UjjawalKhatri/rv64im-doom-soc/docs/images/vga_colorbars.png

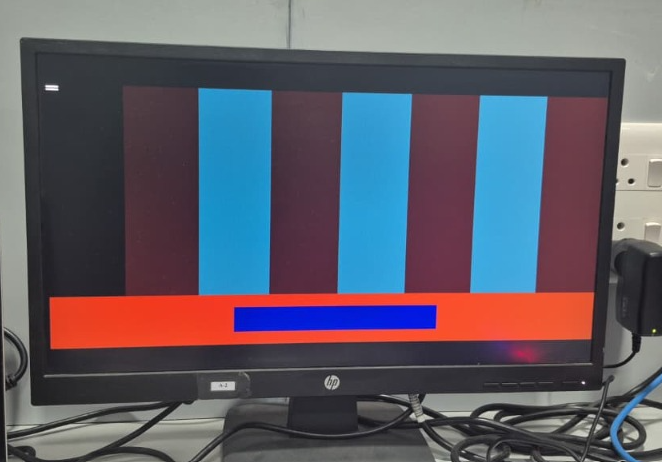
docs/images/vga_colorbars.png
