UjjawalKhatri/rv64im-doom-soc/sim/programs/instructions.txt

00000093
00000113
00000193
00000213
00000293
00000313
00000393
00000413
00000493
00000513
00000593
00000613
00000693
00000713
00000793
00000813
00000893
00000913
00000993
00000a13
00000a93
00000b13
00000b93
00000c13
00000c93
00000d13
00000d93
00000e13
00000e93
00000f13
00000f93
00002117
f7410113
00001297
16c28293
00001317
17030313
0062d863
0002b023
00828293
ff5ff06f
008000ef
0000006f
fe010113
00113c23
00813823
00913423
660000ef
00000593
00000513
78c000ef
00000593
00400513
7a4000ef
00001437
cd040513
225000ef
00001537
d0050513
219000ef
cd040513
211000ef
00400593
00000513
754000ef
00000593
07800513
76c000ef
00001537
d3050513
1ed000ef
00001537
d5050513
1e1000ef
00700593
00000513
724000ef
00000593
07400513
73c000ef
00001537
d8050513
1bd000ef
478000ef
00050493
03200513
4b4000ef
468000ef
00050413
00900593
00000513
6e8000ef
ffff67b7
3c078793
00f407b3
00005737
409787b3
e2070713
08f76e63
07400513
00000593
6e4000ef
00001537
da850513
165000ef
00b00593
00000513
6a8000ef
00000593
00400513
6c0000ef
00001537
de850513
141000ef
0ff00413
000014b7
474000ef
00040793
00050413
fea78ae3
458000ef
00d00593
00000513
668000ef
00000593
07800513
680000ef
3d4000ef
0005061b
0004059b
e0848513
131000ef
434000ef
00040793
00050413
faa78ae3
fc1ff06f
09000513
00000593
64c000ef
00001537
dd050513
0cd000ef
f69ff06f
00060463
0a054e63
08050e63
fc010113
00010613
00100893
00060793
00900313
40c888bb
0080006f
00070513
02b57733
0ff77693
0306881b
0576869b
0ff6f693
00e36463
0ff87693
00d78023
00f8883b
02b55733
00178793
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
786c66e6
00e6666c
606060f0
00fe6662
fefeeec6
00c6c6d6
def6e6c6
00c6c6ce
c6c6c67c
007cc6c6
7c6666fc
00f06060
c6c6c67c
0e7ccec6
7c6666fc
00e6666c
3860c67c
007cc60c
18185a7e
003c1818
c6c6c6c6
007cc6c6
c6c6c6c6
00386cc6
d6c6c6c6
00c6eefe
386cc6c6
00c6c66c
3c666666
003c1818
180cc6fe
00fe6230
3030303c
003c3030
183060c0
0002060c
0c0c0c3c
003c0c0c
c66c3810
00000000
00000000
ff000000
000c1830
00000000
0c780000
0076cc7c
667c60e0
007c6666
c67c0000
007cc6c0
cc7c0c1c
0076cccc
c67c0000
007cc0fe
f0606c38
00f06060
cc760000
f80c7ccc
766c60e0
00e66666
18380018
003c1818
060e0006
3c666606
6c6660e0
00e66c78
18181838
003c1818
feec0000
00d6d6d6
66dc0000
00666666
c67c0000
007cc6c6
66dc0000
f0607c66
cc760000
1e0c7ccc
76dc0000
00f06060
c07c0000
00fc067c
30fc3030
00183430
cccc0000
0076cccc
c6c60000
00386cc6
c6c60000
006cfed6
6cc60000
00c66c38
c6c60000
fc067ec6
4cfe0000
00fe3218
070c0c38
00380c0c
00181818
00181818
380c0c07
00070c0c
00003b6e
00000000
00000000
00000000
00000004
00000013
00000013
00000013
00000013
00000013
00000013
00000013
00000013
00000013
00000013
00000013
00000013
00000013
00000013
00000013
00000013
00000013
00000013
00000013
00000013
00000013
00000013
00000013
00000013
00000013
00000013
00000013
00000013
00000013
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
