UjjawalKhatri/rv64im-doom-soc/sim/programs/fibonacci_instructions.txt

00
A0
00
93
00
00
01
13
00
10
01
93
00
00
02
93
00
22
B0
23
00
31
02
33
00
01
81
13
00
02
01
93
00
82
82
93
FF
F0
80
93
00
00
86
63
FE
00
02
E3
00
00
00
13
00
00
35
03
00
80
35
83
01
00
36
03
01
80
36
83
02
00
37
03
02
80
37
83
03
00
38
03
03
80
38
83
04
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
