UjjawalKhatri/rv64im-doom-soc/docs/images/diagnostic_tests.png

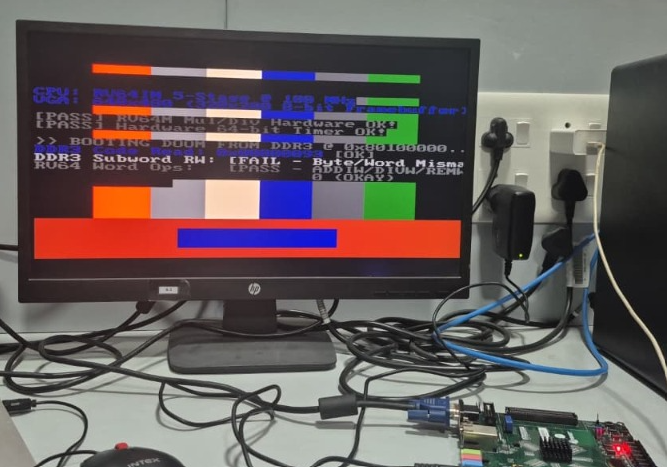
docs/images/diagnostic_tests.png
