UjjawalKhatri/rv64im-doom-soc/docs/images/green_stripes_bug.png

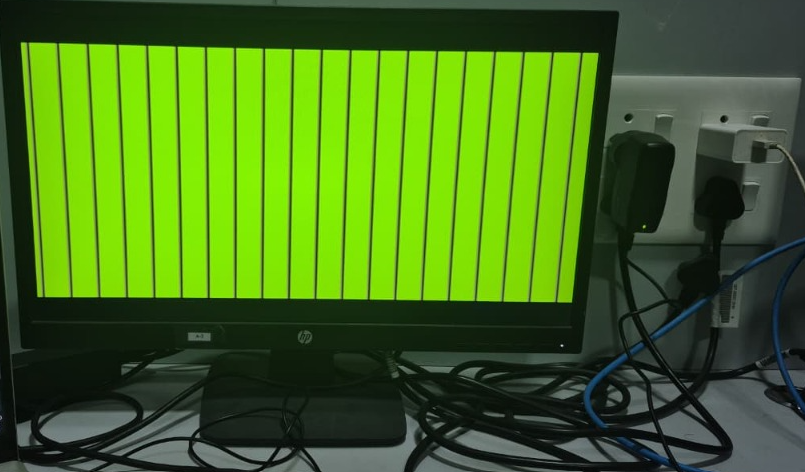
docs/images/green_stripes_bug.png
