UjjawalKhatri/rv64im-doom-soc/sw/doom/doomgeneric/i_system.c

//
// Copyright(C) 1993-1996 Id Software, Inc.
// Copyright(C) 2005-2014 Simon Howard
//
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
// DESCRIPTION:
//



#include <stdlib.h>
#include <stdio.h>
#include <string.h>

#include <stdarg.h>

#ifdef _WIN32
#define WIN32_LEAN_AND_MEAN
#include <windows.h>
#else
#include <unistd.h>
#endif

#ifdef ORIGCODE
#include "SDL.h"
#endif

#include "config.h"

#include "deh_str.h"
#include "doomtype.h"
#include "m_argv.h"
#include "m_config.h"
#include "m_misc.h"
#include "i_joystick.h"
#include "i_sound.h"
#include "i_timer.h"
#include "i_video.h"

#include "i_system.h"

#include "w_wad.h"
#include "z_zone.h"

#ifdef __MACOSX__
#include <CoreFoundation/CFUserNotification.h>
#endif

#define DEFAULT_RAM 6 /* MiB */
#define MIN_RAM     6  /* MiB */


typedef struct atexit_listentry_s atexit_listentry_t;

struct atexit_listentry_s
{
    atexit_func_t func;
    boolean run_on_error;
    atexit_listentry_t *next;
};

static atexit_listentry_t *exit_funcs = NULL;

void I_AtExit(atexit_func_t func, boolean run_on_error)
{
    atexit_listentry_t *entry;

    entry = malloc(sizeof(*entry));

    entry->func = func;
    entry->run_on_error = run_on_error;
    entry->next = exit_funcs;
    exit_funcs = entry;
}

// Tactile feedback function, probably used for the Logitech Cyberman

void I_Tactile(int on, int off, int total)
{
}

// Zone memory auto-allocation function that allocates the zone size
// by trying progressively smaller zone sizes until one is found that
// works.

static byte *AutoAllocMemory(int *size, int default_ram, int min_ram)
{
    byte *zonemem;

    // Allocate the zone memory.  This loop tries progressively smaller
    // zone sizes until a size is found that can be allocated.
    // If we used the -mb command line parameter, only the parameter
    // provided is accepted.

    zonemem = NULL;

    while (zonemem == NULL)
    {
        // We need a reasonable minimum amount of RAM to start.

        if (default_ram < min_ram)
        {
            I_Error("Unable to allocate %i MiB of RAM for zone", default_ram);
        }

        // Try to allocate the zone memory.

        *size = default_ram * 1024 * 1024;

        zonemem = malloc(*size);

        // Failed to allocate?  Reduce zone size until we reach a size
        // that is acceptable.

        if (zonemem == NULL)
        {
            default_ram -= 1;
        }
    }

    return zonemem;
}

#define DOOM_ZONE_BASE 0x82000000ULL
#define DOOM_ZONE_SIZE (16 * 1024 * 1024)

byte *I_ZoneBase (int *size)
{
    *size = DOOM_ZONE_SIZE;
    return (byte *)DOOM_ZONE_BASE;
}

void I_PrintBanner(char *msg)
{
    int i;
    int spaces = 35 - (strlen(msg) / 2);

    for (i=0; i<spaces; ++i)
        putchar(' ');

    puts(msg);
}

void I_PrintDivider(void)
{
    int i;

    for (i=0; i<75; ++i)
    {
        putchar('=');
    }

    putchar('\n');
}

void I_PrintStartupBanner(char *gamedescription)
{
    I_PrintDivider();
    I_PrintBanner(gamedescription);
    I_PrintDivider();

    printf(
    " " PACKAGE_NAME " is free software, covered by the GNU General Public\n"
    " License.  There is NO warranty; not even for MERCHANTABILITY or FITNESS\n"
    " FOR A PARTICULAR PURPOSE. You are welcome to change and distribute\n"
    " copies under certain conditions. See the source for more information.\n");

    I_PrintDivider();
}

//
// I_ConsoleStdout
//
// Returns true if stdout is a real console, false if it is a file
//

boolean I_ConsoleStdout(void)
{
#ifdef _WIN32
    // SDL "helpfully" always redirects stdout to a file.
    return 0;
#else
#if ORIGCODE
    return isatty(fileno(stdout));
#else
	return 0;
#endif
#endif
}

//
// I_Init
//
/*
void I_Init (void)
{
    I_CheckIsScreensaver();
    I_InitTimer();
    I_InitJoystick();
}
void I_BindVariables(void)
{
    I_BindVideoVariables();
    I_BindJoystickVariables();
    I_BindSoundVariables();
}
*/

//
// I_Quit
//

void I_Quit (void)
{
    atexit_listentry_t *entry;

    // Run through all exit functions

    entry = exit_funcs;

    while (entry != NULL)
    {
        entry->func();
        entry = entry->next;
    }

#if ORIGCODE
    SDL_Quit();

    exit(0);
#endif
}

#if !defined(_WIN32) && !defined(__MACOSX__) && !defined(__DJGPP__)
#define ZENITY_BINARY "/usr/bin/zenity"

// returns non-zero if zenity is available

static int ZenityAvailable(void)
{
    return system(ZENITY_BINARY " --help >/dev/null 2>&1") == 0;
}

// Escape special characters in the given string so that they can be
// safely enclosed in shell quotes.

static char *EscapeShellString(char *string)
{
    char *result;
    char *r, *s;

    // In the worst case, every character might be escaped.
    result = malloc(strlen(string) * 2 + 3);
    r = result;

    // Enclosing quotes.
    *r = '"';
    ++r;

    for (s = string; *s != '\0'; ++s)
    {
        // From the bash manual:
        //
        //  "Enclosing characters in double quotes preserves the literal
        //   value of all characters within the quotes, with the exception
        //   of $, `, \, and, when history expansion is enabled, !."
        //
        // Therefore, escape these characters by prefixing with a backslash.

        if (strchr("$`\\!", *s) != NULL)
        {
            *r = '\\';
            ++r;
        }

        *r = *s;
        ++r;
    }

    // Enclosing quotes.
    *r = '"';
    ++r;
    *r = '\0';

    return result;
}

// Open a native error box with a message using zenity

static int ZenityErrorBox(char *message)
{
    int result;
    char *escaped_message;
    char *errorboxpath;
    static size_t errorboxpath_size;

    if (!ZenityAvailable())
    {
        return 0;
    }

    escaped_message = EscapeShellString(message);

    errorboxpath_size = strlen(ZENITY_BINARY) + strlen(escaped_message) + 19;
    errorboxpath = malloc(errorboxpath_size);
    M_snprintf(errorboxpath, errorboxpath_size, "%s --error --text=%s",
               ZENITY_BINARY, escaped_message);

    result = system(errorboxpath);

    free(errorboxpath);
    free(escaped_message);

    return result;
}

#endif /* !defined(_WIN32) && !defined(__MACOSX__) && !defined(__DJGPP__) */


//
// I_Error
//

static boolean already_quitting = false;

void I_Error (char *error, ...)
{
    char msgbuf[512];
    va_list argptr;
    atexit_listentry_t *entry;
    boolean exit_gui_popup;

    if (already_quitting)
    {
        fprintf(stderr, "Warning: recursive call to I_Error detected.\n");
#if ORIGCODE
        exit(-1);
#endif
    }
    else
    {
        already_quitting = true;
    }

    // Milestone: Fatal error! Turn on LEDs = 0xEE
    *(volatile uint64_t *)0x10001008ULL = 0xEEULL;

    // Format the full error message into a local buffer.
    va_start(argptr, error);
    memset(msgbuf, 0, sizeof(msgbuf));
    M_vsnprintf(msgbuf, sizeof(msgbuf), error, argptr);
    va_end(argptr);

    // -------------------------------------------------------------------
    // BARE-METAL FATAL ERROR REVEAL
    // The default vga_text foreground (palette index 4 = 0x0B0B0B) is
    // near-black and invisible on a black screen, which is why fatal
    // errors previously looked like a "solid black monitor". Force a
    // bright-white-on-black console AND mirror the message to the UART
    // (115200 8N1) so it can be captured over serial as well.
    // -------------------------------------------------------------------
    extern void vga_text_init(unsigned char bg_color, unsigned char fg_color);
    extern void vga_text_set_color(unsigned char fg, unsigned char bg);
    extern void vga_text_puts(const char *str);

    // Reliable channel: UART serial (open a terminal at 115200 8N1).
    printf("\n\n*** DOOM FATAL ERROR (I_Error) ***\n%s\n", msgbuf);

    // Visible channel: bright white text on the VGA monitor.
    vga_text_init(0x00, 0x80);   // bg=black(0), fg=white(index 128 = 0xFFFFFF)
    vga_text_set_color(0x80, 0x00);
    vga_text_puts("\n  ========================================\n");
    vga_text_puts("  >>>        DOOM FATAL ERROR         <<<\n");
    vga_text_puts("  ========================================\n\n  ");
    vga_text_puts(msgbuf);
    vga_text_puts("\n\n  System halted.\n");

    // Halt here so no secondary fault (atexit handlers, exit()) can wipe
    // the message before it is read.
    while (1) { }

    // Shutdown. Here might be other errors.

    entry = exit_funcs;

    while (entry != NULL)
    {
        if (entry->run_on_error)
        {
            entry->func();
        }

        entry = entry->next;
    }

    exit_gui_popup = !M_ParmExists("-nogui");

    // Pop up a GUI dialog box to show the error message, if the
    // game was not run from the console (and the user will
    // therefore be unable to otherwise see the message).
    if (exit_gui_popup && !I_ConsoleStdout())
#ifdef _WIN32
    {
        wchar_t wmsgbuf[512];

        MultiByteToWideChar(CP_ACP, 0,
                            msgbuf, strlen(msgbuf) + 1,
                            wmsgbuf, sizeof(wmsgbuf));

        MessageBoxW(NULL, wmsgbuf, L"", MB_OK);
    }
#elif defined(__MACOSX__)
    {
        CFStringRef message;
	int i;

	// The CoreFoundation message box wraps text lines, so replace
	// newline characters with spaces so that multiline messages
	// are continuous.

	for (i = 0; msgbuf[i] != '\0'; ++i)
        {
            if (msgbuf[i] == '\n')
            {
                msgbuf[i] = ' ';
            }
        }

        message = CFStringCreateWithCString(NULL, msgbuf,
                                            kCFStringEncodingUTF8);

        CFUserNotificationDisplayNotice(0,
                                        kCFUserNotificationCautionAlertLevel,
                                        NULL,
                                        NULL,
                                        NULL,
                                        CFSTR(PACKAGE_STRING),
                                        message,
                                        NULL);
    }
#elif defined(__DJGPP__)
    {
        printf("%s\n", msgbuf);
        exit(-1);
    }

#else
    {
        ZenityErrorBox(msgbuf);
    }
#endif

    // abort();
#if ORIGCODE
    SDL_Quit();

    exit(-1);
#else
    exit(-1);
#endif
}

//
// Read Access Violation emulation.
//
// From PrBoom+, by entryway.
//

// C:\>debug
// -d 0:0
//
// DOS 6.22:
// 0000:0000  (57 92 19 00) F4 06 70 00-(16 00)
// DOS 7.1:
// 0000:0000  (9E 0F C9 00) 65 04 70 00-(16 00)
// Win98:
// 0000:0000  (9E 0F C9 00) 65 04 70 00-(16 00)
// DOSBox under XP:
// 0000:0000  (00 00 00 F1) ?? ?? ?? 00-(07 00)

#define DOS_MEM_DUMP_SIZE 10

static const unsigned char mem_dump_dos622[DOS_MEM_DUMP_SIZE] = {
  0x57, 0x92, 0x19, 0x00, 0xF4, 0x06, 0x70, 0x00, 0x16, 0x00};
static const unsigned char mem_dump_win98[DOS_MEM_DUMP_SIZE] = {
  0x9E, 0x0F, 0xC9, 0x00, 0x65, 0x04, 0x70, 0x00, 0x16, 0x00};
static const unsigned char mem_dump_dosbox[DOS_MEM_DUMP_SIZE] = {
  0x00, 0x00, 0x00, 0xF1, 0x00, 0x00, 0x00, 0x00, 0x07, 0x00};
static unsigned char mem_dump_custom[DOS_MEM_DUMP_SIZE];

static const unsigned char *dos_mem_dump = mem_dump_dos622;

boolean I_GetMemoryValue(unsigned int offset, void *value, int size)
{
    static boolean firsttime = true;

    if (firsttime)
    {
        int p, i, val;

        firsttime = false;
        i = 0;

        //!
        // @category compat
        // @arg <version>
        //
        // Specify DOS version to emulate for NULL pointer dereference
        // emulation.  Supported versions are: dos622, dos71, dosbox.
        // The default is to emulate DOS 7.1 (Windows 98).
        //

        p = M_CheckParmWithArgs("-setmem", 1);

        if (p > 0)
        {
            if (!strcasecmp(myargv[p + 1], "dos622"))
            {
                dos_mem_dump = mem_dump_dos622;
            }
            if (!strcasecmp(myargv[p + 1], "dos71"))
            {
                dos_mem_dump = mem_dump_win98;
            }
            else if (!strcasecmp(myargv[p + 1], "dosbox"))
            {
                dos_mem_dump = mem_dump_dosbox;
            }
            else
            {
                for (i = 0; i < DOS_MEM_DUMP_SIZE; ++i)
                {
                    ++p;

                    if (p >= myargc || myargv[p][0] == '-')
                    {
                        break;
                    }

                    M_StrToInt(myargv[p], &val);
                    mem_dump_custom[i++] = (unsigned char) val;
                }

                dos_mem_dump = mem_dump_custom;
            }
        }
    }

    switch (size)
    {
    case 1:
        *((unsigned char *) value) = dos_mem_dump[offset];
        return true;
    case 2:
        *((unsigned short *) value) = dos_mem_dump[offset]
                                    | (dos_mem_dump[offset + 1] << 8);
        return true;
    case 4:
        *((unsigned int *) value) = dos_mem_dump[offset]
                                  | (dos_mem_dump[offset + 1] << 8)
                                  | (dos_mem_dump[offset + 2] << 16)
                                  | (dos_mem_dump[offset + 3] << 24);
        return true;
    }

    return false;
}
