UjjawalKhatri/rv64im-doom-soc/sw/doom/doomgeneric/m_menu.c

//
// Copyright(C) 1993-1996 Id Software, Inc.
// Copyright(C) 2005-2014 Simon Howard
//
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
// DESCRIPTION:
//	DOOM selection menu, options, episode etc.
//	Sliders and icons. Kinda widget stuff.
//


#include <stdlib.h>
#include <ctype.h>


#include "doomdef.h"
#include "doomkeys.h"
#include "dstrings.h"

#include "d_main.h"
#include "deh_main.h"

#include "i_swap.h"
#include "i_system.h"
#include "i_timer.h"
#include "i_video.h"
#include "m_misc.h"
#include "v_video.h"
#include "w_wad.h"
#include "z_zone.h"

#include "r_local.h"


#include "hu_stuff.h"

#include "g_game.h"

#include "m_argv.h"
#include "m_controls.h"
#include "p_saveg.h"

#include "s_sound.h"

#include "doomstat.h"

// Data.
#include "sounds.h"

#include "m_menu.h"


extern patch_t*		hu_font[HU_FONTSIZE];
extern boolean		message_dontfuckwithme;

extern boolean		chat_on;		// in heads-up code

//
// defaulted values
//
int			mouseSensitivity = 5;

// Show messages has default, 0 = off, 1 = on
int			showMessages = 1;


// Blocky mode, has default, 0 = high, 1 = normal
int			detailLevel = 0;
int			screenblocks = 10;

// temp for screenblocks (0-9)
int			screenSize;

// -1 = no quicksave slot picked!
int			quickSaveSlot;

 // 1 = message to be printed
int			messageToPrint;
// ...and here is the message string!
char*			messageString;

// message x & y
int			messx;
int			messy;
int			messageLastMenuActive;

// timed message = no input from user
boolean			messageNeedsInput;

void    (*messageRoutine)(int response);

char gammamsg[5][26] =
{
    GAMMALVL0,
    GAMMALVL1,
    GAMMALVL2,
    GAMMALVL3,
    GAMMALVL4
};

// we are going to be entering a savegame string
int			saveStringEnter;
int             	saveSlot;	// which slot to save in
int			saveCharIndex;	// which char we're editing
// old save description before edit
char			saveOldString[SAVESTRINGSIZE];

boolean			inhelpscreens;
boolean			menuactive;

#define SKULLXOFF		-32
#define LINEHEIGHT		16

extern boolean		sendpause;
char			savegamestrings[10][SAVESTRINGSIZE];

char	endstring[160];

//static boolean opldev;

//
// MENU TYPEDEFS
//
typedef struct
{
    // 0 = no cursor here, 1 = ok, 2 = arrows ok
    short	status;

    char	name[10];

    // choice = menu item #.
    // if status = 2,
    //   choice=0:leftarrow,1:rightarrow
    void	(*routine)(int choice);

    // hotkey in menu
    char	alphaKey;
} menuitem_t;



typedef struct menu_s
{
    short		numitems;	// # of menu items
    struct menu_s*	prevMenu;	// previous menu
    menuitem_t*		menuitems;	// menu items
    void		(*routine)();	// draw routine
    short		x;
    short		y;		// x,y of menu
    short		lastOn;		// last item user was on in menu
} menu_t;

short		itemOn;			// menu item skull is on
short		skullAnimCounter;	// skull animation counter
short		whichSkull;		// which skull to draw

// graphic name of skulls
// warning: initializer-string for array of chars is too long
char    *skullName[2] = {"M_SKULL1","M_SKULL2"};

// current menudef
menu_t*	currentMenu;

//
// PROTOTYPES
//
void M_NewGame(int choice);
void M_Episode(int choice);
void M_ChooseSkill(int choice);
void M_LoadGame(int choice);
void M_SaveGame(int choice);
void M_Options(int choice);
void M_EndGame(int choice);
void M_ReadThis(int choice);
void M_ReadThis2(int choice);
void M_QuitDOOM(int choice);

void M_ChangeMessages(int choice);
void M_ChangeSensitivity(int choice);
void M_SfxVol(int choice);
void M_MusicVol(int choice);
void M_ChangeDetail(int choice);
void M_SizeDisplay(int choice);
void M_StartGame(int choice);
void M_Sound(int choice);

void M_FinishReadThis(int choice);
void M_LoadSelect(int choice);
void M_SaveSelect(int choice);
void M_ReadSaveStrings(void);
void M_QuickSave(void);
void M_QuickLoad(void);

void M_DrawMainMenu(void);
void M_DrawReadThis1(void);
void M_DrawReadThis2(void);
void M_DrawNewGame(void);
void M_DrawEpisode(void);
void M_DrawOptions(void);
void M_DrawSound(void);
void M_DrawLoad(void);
void M_DrawSave(void);

void M_DrawSaveLoadBorder(int x,int y);
void M_SetupNextMenu(menu_t *menudef);
void M_DrawThermo(int x,int y,int thermWidth,int thermDot);
void M_DrawEmptyCell(menu_t *menu,int item);
void M_DrawSelCell(menu_t *menu,int item);
void M_WriteText(int x, int y, char *string);
int  M_StringWidth(char *string);
int  M_StringHeight(char *string);
void M_StartMessage(char *string,void *routine,boolean input);
void M_StopMessage(void);
void M_ClearMenus (void);




//
// DOOM MENU
//
enum
{
    newgame = 0,
    options,
    loadgame,
    savegame,
    readthis,
    quitdoom,
    main_end
} main_e;

menuitem_t MainMenu[]=
{
    {1,"M_NGAME",M_NewGame,'n'},
    {1,"M_OPTION",M_Options,'o'},
    {1,"M_LOADG",M_LoadGame,'l'},
    {1,"M_SAVEG",M_SaveGame,'s'},
    // Another hickup with Special edition.
    {1,"M_RDTHIS",M_ReadThis,'r'},
    {1,"M_QUITG",M_QuitDOOM,'q'}
};

menu_t  MainDef =
{
    main_end,
    NULL,
    MainMenu,
    M_DrawMainMenu,
    97,64,
    0
};


//
// EPISODE SELECT
//
enum
{
    ep1,
    ep2,
    ep3,
    ep4,
    ep_end
} episodes_e;

menuitem_t EpisodeMenu[]=
{
    {1,"M_EPI1", M_Episode,'k'},
    {1,"M_EPI2", M_Episode,'t'},
    {1,"M_EPI3", M_Episode,'i'},
    {1,"M_EPI4", M_Episode,'t'}
};

menu_t  EpiDef =
{
    ep_end,		// # of menu items
    &MainDef,		// previous menu
    EpisodeMenu,	// menuitem_t ->
    M_DrawEpisode,	// drawing routine ->
    48,63,              // x,y
    ep1			// lastOn
};

//
// NEW GAME
//
enum
{
    killthings,
    toorough,
    hurtme,
    violence,
    nightmare,
    newg_end
} newgame_e;

menuitem_t NewGameMenu[]=
{
    {1,"M_JKILL",	M_ChooseSkill, 'i'},
    {1,"M_ROUGH",	M_ChooseSkill, 'h'},
    {1,"M_HURT",	M_ChooseSkill, 'h'},
    {1,"M_ULTRA",	M_ChooseSkill, 'u'},
    {1,"M_NMARE",	M_ChooseSkill, 'n'}
};

menu_t  NewDef =
{
    newg_end,		// # of menu items
    &EpiDef,		// previous menu
    NewGameMenu,	// menuitem_t ->
    M_DrawNewGame,	// drawing routine ->
    48,63,              // x,y
    hurtme		// lastOn
};
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
