UjjawalKhatri/rv64im-doom-soc/(commit log)

2026-09-02 rtl(core): add RV64IM 5-stage pipeline datapath
2026-09-02 rtl(peripherals): add VGA timing, framebuffer and palette RAM
2026-09-02 rtl(peripherals): add GPIO, timer and UART MMIO blocks
2026-09-02 constraints: add ZedBoard XDC pin and timing constraints
2026-09-02 scripts(vivado): add one-shot project creation and build flow
2026-09-03 sw(drivers): add UART, timer, GPIO and VGA MMIO drivers
2026-09-03 sw(doom): add RV64 platform layer, framebuffer blit and build script
2026-09-03 sw(doom): add in-memory WAD driver and provenance documentation
2026-09-03 scripts(jtag): add programming, DAP memory load and frame-rate telemetry
2026-09-04 docs: apply Round 2 correctness fixes and add AUTHORS specification
    - Fix hardware controls table to match DG_GetKey() implementation exactly (BTNC is reset)
    - Correct Quick Start step 5 (BTND to launch, SW2 UP to select)
    - Clarify memory fabric as fixed-priority DDR arbiter (D-side ahead of I-side)
    - Clarify multi-cycle multiplier and divider with pipeline stalls
    - Clarify single 100 MHz clock domain with 25 MHz pixel-enable strobe for VGA
    - Reconcile hero caption and performance table frame rates
    - Mark DDR round-trip latency as estimated and cite 48.75 cycles/store
    - Mark vendored DOOM engine and generated mem files in .gitattributes for Linguist
    - Remove premature references to GitHub Re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
2026-09-08 feat(timing): sync timing-optimized RTL, verified regressions, frequency-aware build flow and 1024-frame telemetry
