UjjawalKhatri/rv64im-doom-soc/(notices)

Notices in the files:
sw/doom/doomgeneric/st_stuff.c:
modify it under the terms of the GNU General Public License
README.md:
License: GPL-2.0
